nimnamudithani/ChromoBot-Autonomous-Sorter/Designs/Engineering Design Specification - ChromoBot.docx

Engineering Design Specification (EDS) for Project ChromoBot.

PROJECT CHROMOBOT: FINAL ENGINEERING SPECIFICATION

Version: 1.0 (Final)

Architecture: Arduino Mega 2560 + ESP8266 (Integrated)

Power System: Tri-Rail (7.4V / 6.0V / 5.0V)

1. MECHANICAL & STRUCTURAL DESIGN

A. Chassis Configuration ("The Double-Decker")

- Base Frame: 4WD Acrylic Chassis (Double Plate).
- Battery Placement: Mounted low, preferably underslung or sandwiched between the two plates. Critical for lowering Center of Gravity.
- Top Plate Layout:
  - Front Center: 4-DOF Robotic Arm. Must be counterweighted.
  - Rear Center: Custom PCB + Arduino Mega. (Acts as counterweight to the Arm).
  - Front Corners: Side Ultrasonic Sensors (Left & Right).
- Bottom Plate Layout:
  - Front Edge (Underslung): Front Ultrasonic Sensor. Must skim the floor to detect short 3cm cubes.
  - Front Edge (Underslung): IR Line Array. Sensor gap to ground must be 2mm – 10mm.

B. Payload & Environment

- Objects: 3cm × 3cm Cubes (Matte painted Red / Green / Blue).
- Walls: Minimum height 10cm. Corridor width Robot Width + 10cm.
- Lines: 20mm Black Tape on White Surface.

2. ELECTRICAL CONNECTIONS (THE MASTER MAP)

A. The "Forbidden Pins" (DO NOT USE)

- D0 / D1: Reserved for USB Programming.
- D14 / D15: Reserved for Internal Wi-Fi (ESP8266) communication. Must remain unconnected on PCB.

B. Mega 2560 Pinout Table

Connect your PCB headers (TO_MEGA_LOGIC) to these exact pins using jumper wires.

Function | Mega Pin | Connects To (Module) | Notes
Left Motor PWM | D2 | TB6612 PWMA | Speed Control
Right Motor PWM | D3 | TB6612 PWMB | Speed Control
I2C Data | D20 | Color Sensor SDA & PCA9685 SDA | Bus: Wire together
I2C Clock | D21 | Color Sensor SCL & PCA9685 SCL | Bus: Wire together
Left Motor Dir 1 | D22 | TB6612 AIN1 | Direction Logic
Left Motor Dir 2 | D23 | TB6612 AIN2 | Direction Logic
Right Motor Dir 1 | D24 | TB6612 BIN1 | Direction Logic
Right Motor Dir 2 | D25 | TB6612 BIN2 | Direction Logic
Front US Trig | D30 | Ultrasonic Header 1 TRIG | For Cube Detection
Front US Echo | D31 | Ultrasonic Header 1 ECHO | For Cube Detection
Left US Trig | D32 | Ultrasonic Header 2 TRIG | For Wall Centering
Left US Echo | D33 | Ultrasonic Header 2 ECHO | For Wall Centering
Right US Trig | D34 | Ultrasonic Header 3 TRIG | For Wall Centering
Right US Echo | D35 | Ultrasonic Header 3 ECHO | For Wall Centering
IR Sensor 1 | D36 | IR Array Pin S1 | Line Following
IR Sensor 2 | D37 | IR Array Pin S2 | Line Following
IR Sensor 3 | D38 | IR Array Pin S3 | Line Following
IR Sensor 4 | D39 | IR Array Pin S4 | Line Following
IR Sensor 5 | D40 | IR Array Pin S5 | Line Following
Color LED Ctrl | D41 | Color Sensor LED | Turn light on/off
Color Interrupt | D42 | Color Sensor INT | (Optional)
IR Crash/Near | D43/D44 | IR Array CLP / NEAR | (Optional)

3. POWER SYSTEM ARCHITECTURE

A. Power Rails (Tri-Rail System)

1. Rail 1: RAW BATTERY (7.4V – 8.4V)
  - Source: 2x 18650 Li-Ion.
  - Connects To: TB6612FNG Pin 1 (VM).
  - Rule: Motors get raw power. Do not route this through regulators. Software PWM limit required (~80%).
2. Rail 2: SERVO POWER (6.0V)
  - Source: LM2596 Regulator #1.
  - Connects To: PCA9685 Pin 29 (V+).
  - Constraint: Tune potentiometer to exactly 6.0V before connecting servos.
3. Rail 3: LOGIC POWER (5.0V)
  - Source: LM2596 Regulator #2.
  - Connects To: Mega 5V, TB6612 VCC, PCA9685 VCC, Sensors.
  - Constraint: Tune potentiometer to exactly 5.0V.

B. Noise Suppression (Capacitors)

- Bulk Storage (470µF Electrolytic):
  - C1: At Battery Input (before regulators).
  - C2: At Servo Power Header (PCA9685 input).
  - C3: At 5V Logic Rail output.
- Decoupling (100nF Ceramic):
  - Placed physically close to VCC/GND pins of every sensor header and module (TB6612, PCA9685, IR, Color, Ultrasonic).

4. PCB FABRICATION RULES (DIY ETCHING)

- Track Width: 1.2mm (approx 48 mil) for all traces.
- Clearance: 0.8mm minimum between copper features.
- Ground Plane: Bottom layer filled with Copper Pour (GND).
- Thermal Relief: Use spokes for GND pads (do not use direct connect, or soldering will be impossible with 1.2mm tracks).
- Pad Size: Manually increase all header pads to 2.0mm+ Circular/Oval to allow for drill misalignment.
- Wi-Fi Safety Zone: Remove all copper (tracks and ground pour) from the PCB area directly underneath the Mega's ESP8266 antenna.

5. CONTROL LOGIC & SOFTWARE

A. Hardware Setup (DIP Switches)

- Mode 1: USB Programming (Upload Code)
  - Switch 3 & 4: ON
  - Switch 1 & 2: OFF
  - Switch 5-8: OFF
- Mode 2: Robot Operation (Remote Control Active)
  - Switch 3 & 4: OFF
  - Switch 1 & 2: ON (Connects ESP8266 to Mega Serial3)
  - Switch 5-8: OFF

B. Communication Protocol (Wi-Fi)

- Channel: Serial3 (Baud rate usually 115200, check your board logic).
- Packet Format: <Type, ID, Value>
  - Example: <M, 0, 200> (Move Speed 200)
  - Example: <S, 2, 90> (Servo #2 to 90°)
- Safety Watchdog: If no packet received for >500ms, execute stopAllMotors().

C. Autonomous Navigation Strategy

1. Line Following Mode: Uses PID on IR Array error.
  - Logic: Error = (Position - Center). Correction = Kp * Error.
2. Corridor Mode (Walls): Uses Difference Logic on Side Ultrasonics.
  - Logic: Error = (Left_Distance - Right_Distance). MotorDiff = Kp * Error.
3. Cube Approach:
  - Sensor: Front Ultrasonic (Bottom Plate).
  - Logic:
    - Dist > 15cm: Fast Approach.
    - Dist < 15cm: Slow Approach.
    - Dist < 4cm: STOP & Handover to Arm.

6. COMPONENT LIST (FINAL CHECK)

1. MCU: Arduino Mega + WiFi R3 (Integrated ESP8266).
2. Motor Driver: TB6612FNG (Dual Driver, 1 unit used for 4 motors).
3. Servo Driver: PCA9685 (I2C 16-Channel).
4. Servos: 4x MG90S (Metal Gear).
5. Sensors:
  - 3x HC-SR04 Ultrasonic.
  - 1x TCRT5000 5-Ch IR Array.
  - 1x TCS34725 Color Sensor (I2C).
6. Power: 2x LM2596 Buck Converters.
7. Capacitors: 3x 470µF (16V+), 9x 100nF Ceramic.
