nimnamudithani/ChromoBot-Autonomous-Sorter/Designs/Chromobot_Silk_Layer.pdf

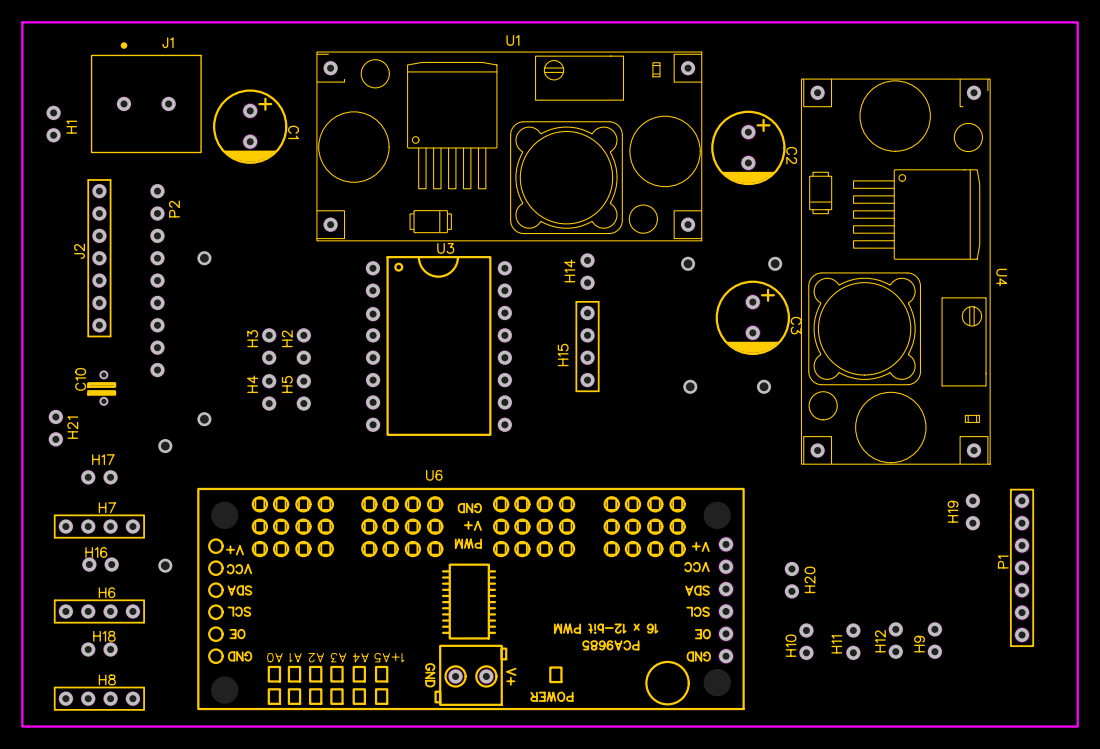
[picture p2: page 1]
