nimnamudithani/ChromoBot-Autonomous-Sorter/Designs/map.pdf

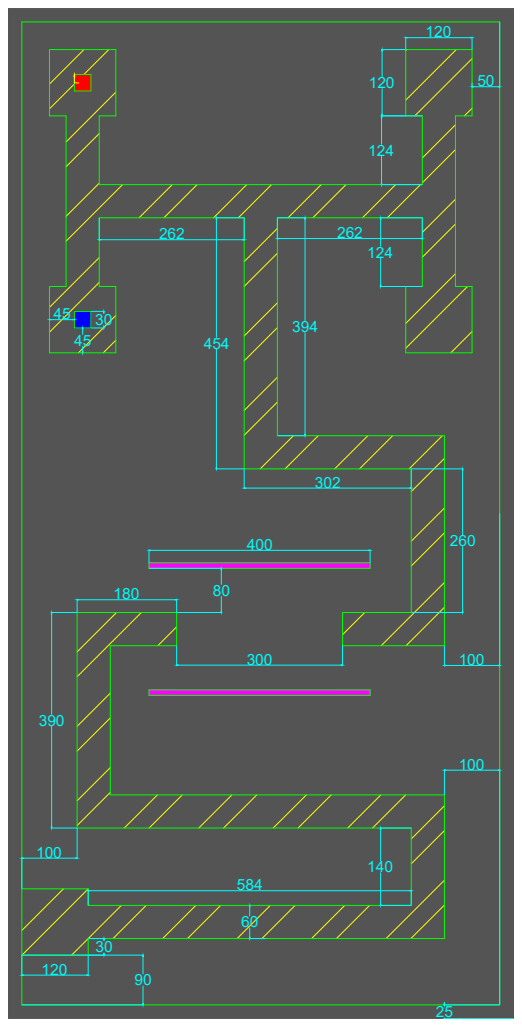
[picture p3: page 1]
