nimnamudithani/ChromoBot-Autonomous-Sorter/Designs/PCB_PCB_ChromoBot_2026-01-02 (1).pdf

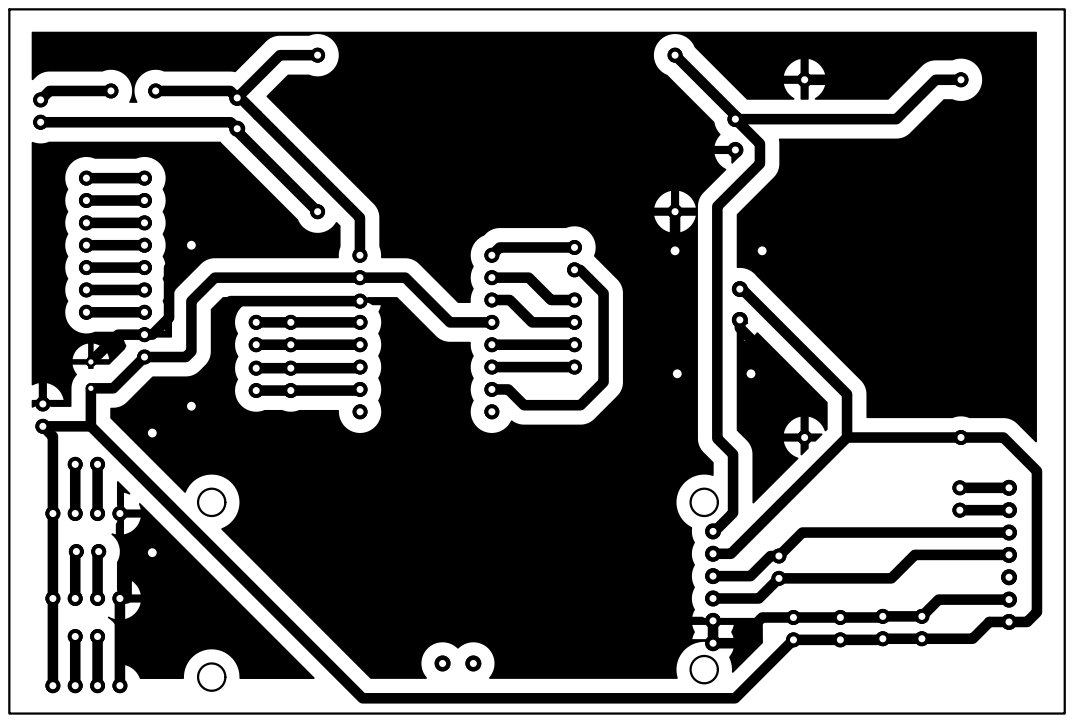
[picture p4: page 1]
