nimnamudithani/ChromoBot-Autonomous-Sorter/Designs/Schematic_ChromoBot_2025-12-30.pdf

# Input

# Motor Driver (TB6612FNG)

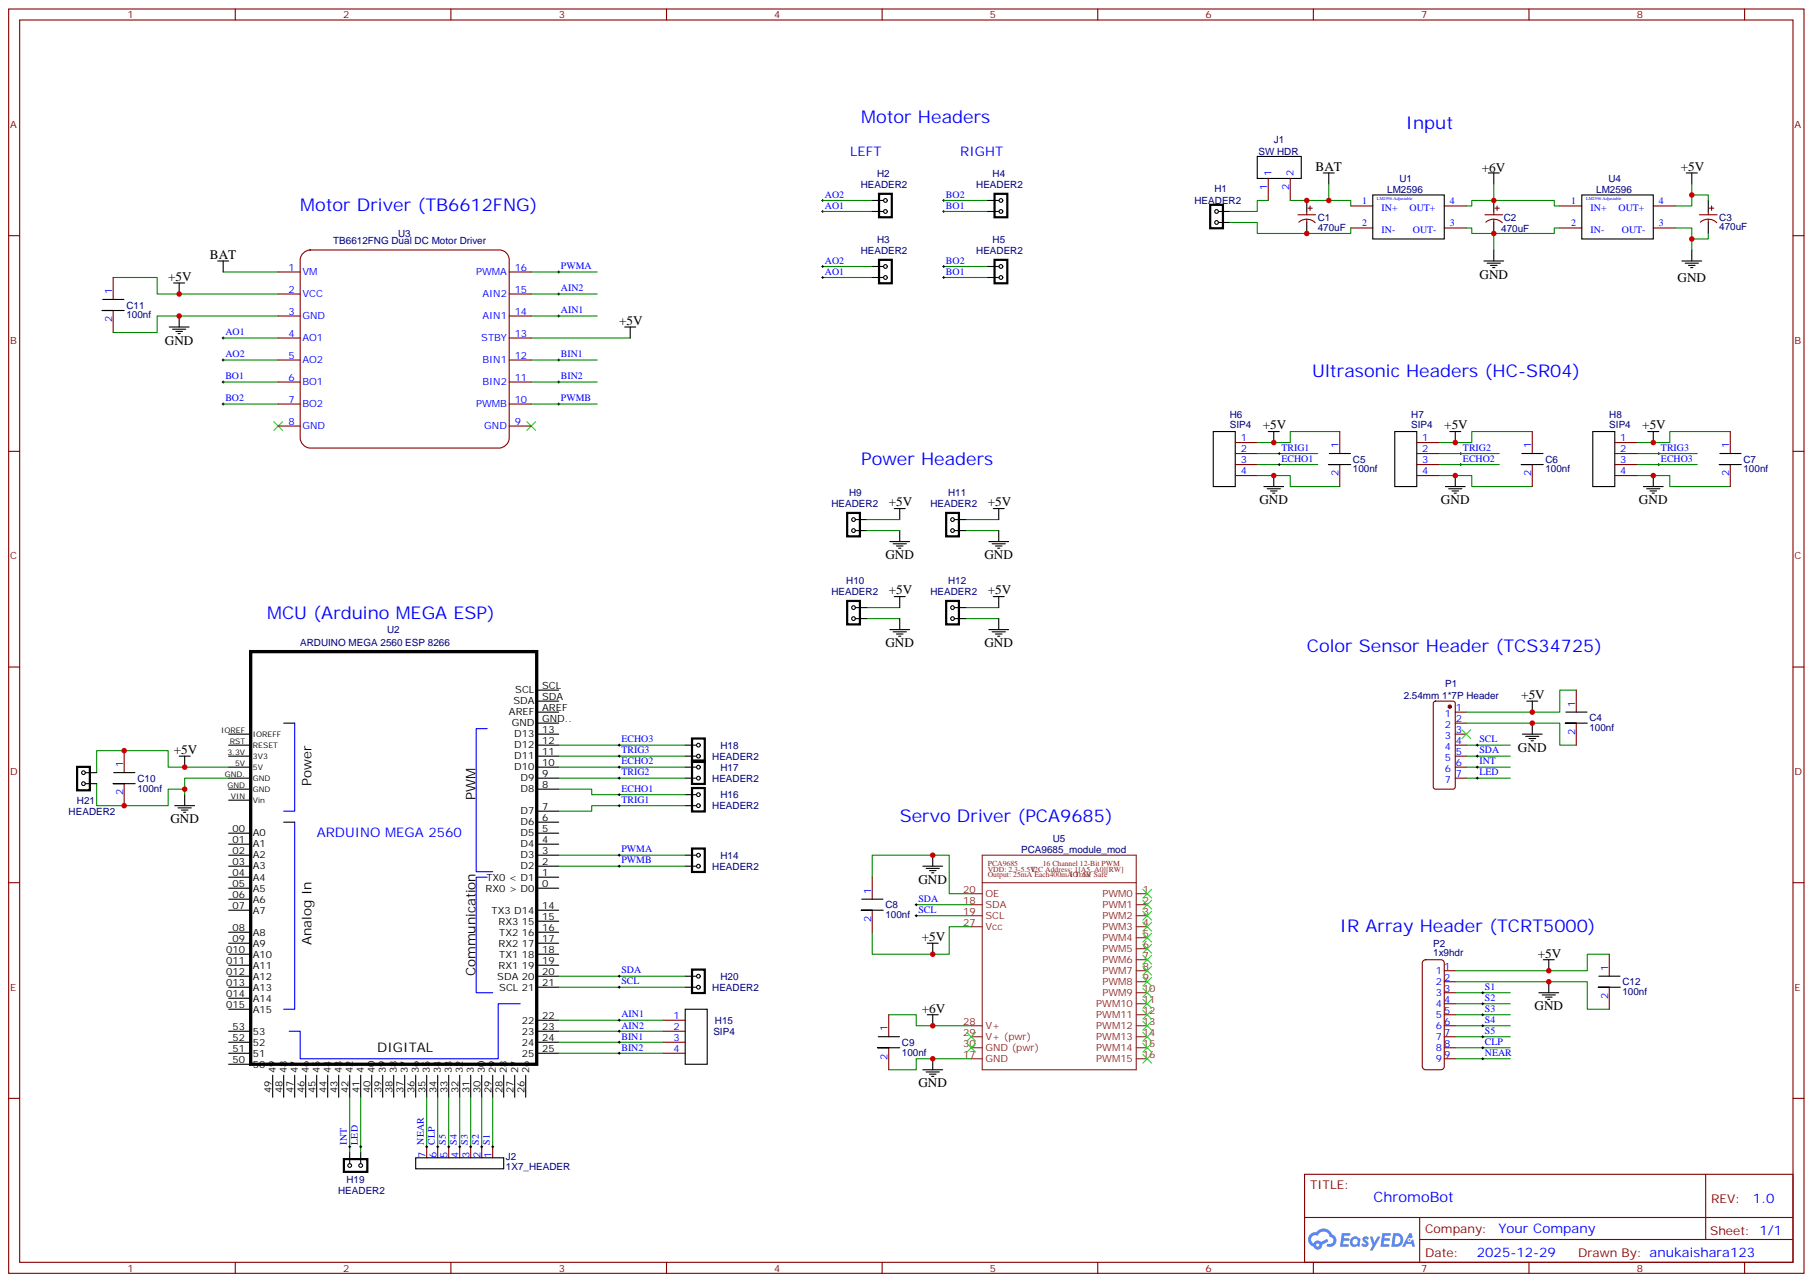
[picture p1: page 1]

TB6612FNG Dual DC Motor Driver

MCU (Arduino MEGA ESP)
